perryrob/urban_micro/README.md

# urban_micro
Use OopenSCAD and modules to contruct a home in 3-D to achieve accurate part counts

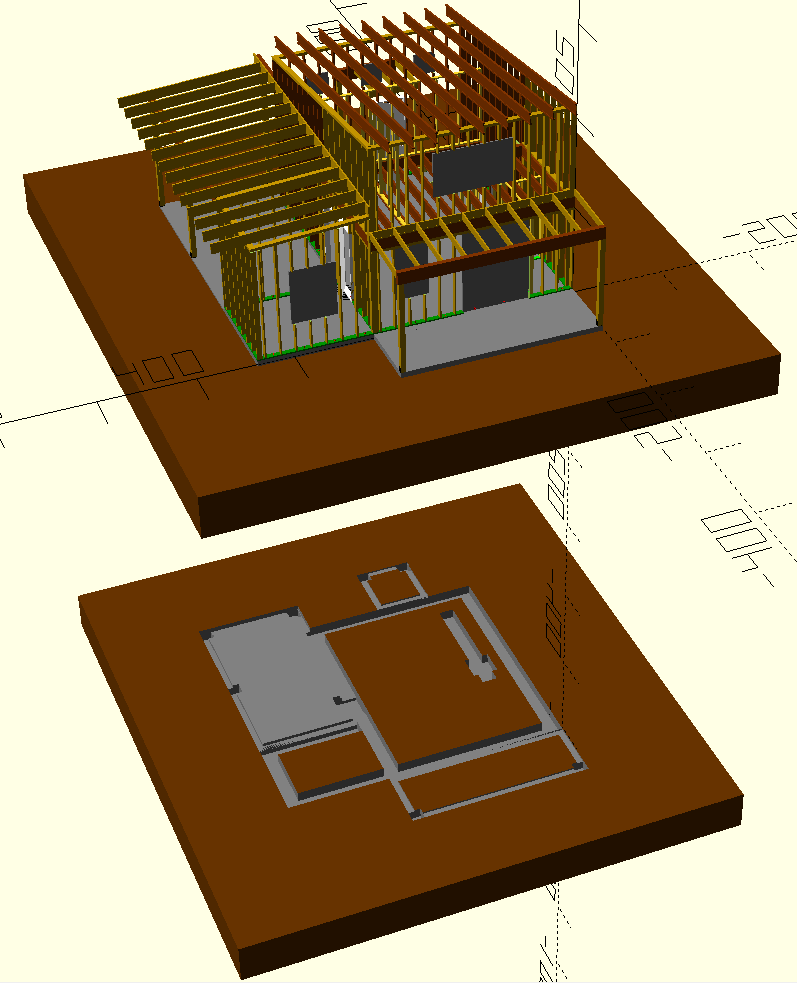
[picture p1: images/ortho.png]


clone and load "micro.scad"

# Requirements
* OpenSCAD installed
