perryrob/urban_micro/Urban_Micro_BOM.ods

Sheet: Sheet1
Category
Foundation
Brackets
 | Part | Qty | DWG Location | Est Price | Act Price | Total Est | Total Act | Notes
 | LSTHD8 | 10 | 3-A4 | $18.00 |  | $180.00
 | OCB46 | 3 | 3-A4 | $20.00 |  | $60.00
 | APB66 | 8 | 3-A4 | $50.00 |  | $400.00
 | ½ J bolts | 50 | 3-A4 | $1.70 |  | $85.00
 | SSTB 5/8 J Bolts | 12 | 1-A2 | $9.31 |  | $111.72
Slab | Part | Qty | DWG Location | Est Price | Act Price | Total Est | Total Act | Notes
 | #4 Rebarx20’ | 12 | 3-A4 | $12.00 |  | $144.00
 | Concrete | 20 | 3-A4 | $170.00 |  | $3,400.00
 | AB Gravel | 8 | 3-A4 | $60.00 |  | $480.00
 | Earth Work | 1 |  | $3,600.00 |  | $3,600.00 |  | labor
 | Trenching | 1 |  | $800.00 |  | $800.00 |  | labor
 | Plumbing | 1 |  | $4,500.00 |  | $4,500.00 |  | labor
 | Form | 1 |  | $2,000.00 |  | $2,000.00 |  | labor
Plumbing | Part | Qty | DWG Location | Est Price | Act Price | Total Est | Total Act | Notes
 | 3 inch Waste 10’ | 12 |  | $60.00 |  | $720.00
 | Waste Fittings | 6 |  | $10.00 |  | $60.00
 |  |  |  |  |  | $0.00
 |  |  |  |  |  | $0.00
 |  |  |  |  |  | $0.00
Windows | Part | Qty | DWG Location | Est Price | Act Price | Total Est | Total Act | Notes
 | 24”x24” Fixed | 3 |  | $450.36 |  | $1,351.08 |  | U-FACTOR OF 0.40 OR BETTER AND SOLAR HEAT GAIN COEFFICIENT OF 0.25 OR BETTER
 | 7'-0" x 4'-6" DBL. CASE | 1 |  | $3,449.70 |  | $3,449.70 |  | U-FACTOR OF 0.40 OR BETTER AND SOLAR HEAT GAIN COEFFICIENT OF 0.25 OR BETTER
 | 3'-0" x 4'-6" S.H | 1 |  | $1,156.00 |  | $1,156.00 |  | U-FACTOR OF 0.40 OR BETTER AND SOLAR HEAT GAIN COEFFICIENT OF 0.25 OR BETTER
 | 6'-0" x 8'-0" GLASS SLIDER | 1 |  | $5,602.71 |  | $5,602.71 |  | U-FACTOR OF 0.40 OR BETTER AND SOLAR HEAT GAIN COEFFICIENT OF 0.25 OR BETTER
 | 3'-0" x 5'-0" S.H. | 1 |  | $1,231.39 |  | $1,231.39 |  | U-FACTOR OF 0.40 OR BETTER AND SOLAR HEAT GAIN COEFFICIENT OF 0.25 OR BETTER
 | 4'-0" x 5'-0" S.H | 1 |  | $1,373.89 |  | $1,373.89 |  | U-FACTOR OF 0.40 OR BETTER AND SOLAR HEAT GAIN COEFFICIENT OF 0.25 OR BETTER
Doors | Part | Qty | DWG Location | Est Price | Act Price | Total Est | Total Act | Notes
 | Exterior 36”x96” | 1 |  | $1,828.29 |  | $1,828 |  | Right Hinged tempered partial glass
 | Interior 32”x80” | 2 |  | $215.00 |  | $430 |  | Right Handed hollow core
 | Exterior 32”x80” | 1 |  | $1,308.46 |  | $1,828 |  | Right Hinged tempered partial glass
 | Interior 32”x80” | 1 |  | $122.82 |  | $123 |  | Left Handed Opening
Toilets |  | Qty | DWG Location | Est Price | Act Price | Total Est | Total Act | Notes
 | Geberit 111.798.00.1 | 2 |  | $456.00 |  | $912 |  | https://www.amazon.com/Geberit-111-798-00-1-Concealed-Carrier-Dual-Flush/dp/B01C7FL4PK
 | Duravit 2226090092 Toilet Bowl | 2 |  | $340.00 |  | $680 |  | https://www.amazon.com/Duravit-2226090092-Toilet-Mounted-Starck/dp/B00F0IZMJ6
 |  |  |  |  |  | $0
 |  |  |  |  |  | $0
Main Floor Walls |  | Qty | DWG Location | Est Price | Act Price | Total Est | Total Act | Notes
 | Versalam 1 ½ x 5 ½ 16 ft EWN wall | 36 |  | $72.00 |  | $2,592
 | 2x6x12 Bottom Plate Treated | 10 |  | $10.00 |  | $100
 | 2x6x12 Top Plates | 20 |  | $20.00 |  | $400
 | CDX Sheathing | 24 |  | $31.00 |  | $744
 | Interior Walls | 0 |  |  |  |  |  | Guest Room
 | 2x6 12 foot | 30 |  | $12.00 |  | $360 |  | includes fire blocking
 | 2x4 8 foot | 23 |  | $7.12 |  | $164
 | 2x6 x 8 ft | 30 |  | $8.22 |  | $247
Upper Floor Walls |  | Qty | DWG Location | Est Price | Act Price | Total Est | Total Act | Notes
 | 2x4 10 foot | 10 |  | $7.12 |  | $71
 | 2x4x12 foot | 8 |  | $10.00 |  | $80
 |  | 4 |  | $20.00 |  | $80
 | CDX Sheathing | 0 |  | $47.00 |  | $0
 | 5 1/8" x 12" GLULAM 16 ft | 0 |  | $673.00 |  | $0
Upper Floor Framing |  | Qty | DWG Location | Est Price | Act Price | Total Est | Total Act | Notes
 | 11 7/8" FLOOR TJI's (230 SERIES) 12 footers | 15 |  | $168.00 |  | $2,520
 | Subfloor ¾ | 9 |  | $47.00 |  | $423
 | ITS Galvanized Top-Flange Joist Hanger for 2-5/16 in. x 11-7/8 in | 30 |  | $6.56 |  | $197
 | South Rim Joist
 | EW Rim Joist
Main Roof
 | 11 7/8" ROOF TJI's (560 SERIES) 24 footers | 12 |  | $335.76 |  | $4,029
 | CDX Sheeting | 21 |  | $31.00 |  | $651
 | Simpson H3 | 16 |  | $1.12 |  | $18
Carport and Guest Roof |  | Qty | DWG Location | Est Price | Act Price | Total Est | Total Act | Notes
 | Rafter Joists 2x12 12 ft | 12 |  | $12.00 |  | $144
 | 1x6 8 foot tongue and groove | 104 |  | $18.00 |  | $1,872
 | CDX Sheeting | 12 |  | $31.00 |  | $372
 | Sheeting | 8 |  | $46.55 |  | $372
 | Main Roof Fascia | 12 |  | $10.00 |  | $120
 | Simpson H3 | 30 |  | $1.12 |  | $34
 | Simpson LU36 | 12 |  | $2.68
 | 2x12 12 ft | 8 |  | $24.54 |  | $196
 | 5 1/2" x 9 3/4" GLULAM 20 foot | 1 |  | $500.00 |  | $500
Porches |  | Qty | DWG Location | Est Price | Act Price | Total Est | Total Act | Notes
 | 5 1/2" x 9 3/4" GLULAM 30 foot | 1 |  | $673.00 |  | $673
 | 6x6 Post 10 foot | 6 |  | $56.00 |  | $336
 | 6x6 Post 12foot | 2 |  | $67.00 |  | $134
 | Simpson O(E)CC 66 | 7 |  | $81.16 |  | $568
 | 5/8 in. x 8 in. Hot-Dip Galvanized Retrofit Bolt (2-Pack) | 21 |  | $19.00 |  | $399
 | Rafter Joists 2x8 8 ft | 10 |  | $10.12 |  | $101
 | 1x6 8 foot tongue and groove | 31 |  | $18.00 |  | $558
Electrical |  | Qty | DWG Location | Est Price | Act Price | Total Est | Total Act | Notes
 | 150 Amp 30-Space Outdoor Load Center Meter Main Combo with Main Breaker | 1 |  | $400.00 |  | $400
 | Misc mast rigging | 1 |  | $400.00 |  | $400
Bathroom |  | Qty | DWG Location | Est Price | Act Price | Total Est | Total Act | Notes
 | Sink KOHLER Cimarron 8 in. Widespread Vitreous China Pedestal Combo Bathroom | 2 |  | $312.00 |  | $624
 | Faucet MOEN Adler 4 in. Centerset 2-Handle | 2 |  | $60.00 |  | $120
 | Mirror JENSEN Horizon 16 in. W x 26 in. H x 4-3/4 in. D Frameless Recessed | 2 |  | $103.00 |  | $206
 | Shower | 2 |  | $2,000.00 |  | $4,000
Roof |  | Qty | DWG Location | Est Price | Act Price | Total Est | Total Act | Notes
 | Metal roof | 1 |  | $8,000.00 |  | $8,000
Stucco |  | Qty | DWG Location | Est Price | Act Price | Total Est | Total Act | Notes
 | Stucco | 1 |  | $8,000.00 |  | $8,000
Appliances |  | Qty | DWG Location | Est Price | Act Price | Total Est | Total Act | Notes
 | Refrigerator | 1 |  | $1,500.00 |  | $1,500
 | Dishwasher | 1 |  | $800.00 |  | $800
 | Sink | 1 |  | $400.00 |  | $400
 | Stove | 1 |  | $1,100.00 |  | $1,100
 | Counter | 1 |  | $1,000.00 |  | $1,000
 | Cabinets | 1 |  | $4,000.00 |  | $4,000
Flooring |  | Qty | DWG Location | Est Price | Act Price | Total Est | Total Act | Notes
 | Bamboo Flooring Eco Forest Premium Carbonized | 700 |  | $3.00 |  | $2,100
MISC |  | Qty | DWG Location | Est Price | Act Price | Total Est | Total Act | Notes
 | Tyvek $224 / 1350 2100 AREA | 2 |  | $224.00 |  | $448
 | Drywall ½ inch Ultralight | 105 |  | $16.58 |  | $1,741
 | Drywall ½ inch Ultralight Green | 20 |  | $23.93 |  | $479
 | Spray Foam | 1 |  | $1,800.00 |  | $1,800
 | Permitting | 1 |  | $8,000.00 | 4902.64 | $8,000

Sheet: Sheet2
Main Interior
 | East Wall | 24
 | North Wall | 18
 | West Wall | 24
 | South Wall | 18
Guest | North Wall | 10.5
 | West Wall | 9
 | South Wall | 10.5
Enclosed Perimeter |  | 114
Main Surface Area
 | East Wall
 |  | H1
 |  |  | 14.1666666666667
 |  | H2
 |  |  | 18
 | Area | 386
 | West Wall | 278
Guest | West Wall | 90
 | North Wall | 120
 | South Wall | 120
Main Roof
South | 20
West | 28
 | Area | 560
Carport+Guest | 30
 | 12
 | Area | 360
Porch
 | 18
 | 6
 | Area | 108
 | 6
 | 4
 |  | 24
