perryrob/urban_micro/foundation.scad

function ft(d) = 12.0*d ;

// Southeast is 0,0,0
slab_north = ft(23)+9+0.25;
slab_west = ft(18)+0.25;
slab_thk = 4;

g_slab_north = ft(8)+9+0.25;
g_slab_west = ft(10)+1+.75;

d_slab_north = ft(18)+10+.5;
d_slab_west = ft(10)+7+0.75;

p_slab_north = ft(6)+1+0.5;
p_slab_west = ft(18)+0.25;

dr_slab_north = ft(6)+1+0.5;
dr_slab_west = ft(5)+7+0.5;

ex_footer_width=ft(1);

toe_down_width=8;

MAIN_SLAB=[slab_north,slab_west,slab_thk];

module concrete(){
  color([0.5,0.5,0.5]) children();
}
module black_steel(){
   color([0,0,0]) children();
}

module APVB66() {
  echo("{name='Simpson 4x4 APVB66', type='bracket', qty=1}");
  echo("{name='5/8 J-Bolt', type='jbolt', length=8, qty=1}");
  black_steel()
    union(){
    cube([5,5.5,0.75]);
    difference(){
      union() {
        cube([5,0.125,6]);
        translate([0,5.5,0])
          cube([5,0.125,6]);
      }
      union(){
        translate([1.0,-3,4.5])
          rotate([-90,0,0])
          cylinder(d=0.75,h=10);
        translate([4,-3,4.5])
          rotate([-90,0,0])
          cylinder(d=0.75,h=10);
      }
    }
  }
}
module CB46(){
  echo("{name='Simpson 4x4 CB46', type='bracket', qty=1}");
  black_steel()
    difference(){
    union(){
      translate([0,(3+9/16)/2,0])
        cube([3,0.125,10],center=true);
      translate([0,-(3+9/16)/2,0])
        cube([3,0.125,10],center=true);
      cube([5.5,3+9/16,0.125],center=true);
    }
    union(){
      translate([0,-4,4.325])
        rotate([-90,0,0])
        cylinder(d=0.75,h=10);
      translate([0,-4,2])
        rotate([-90,0,0])
      cylinder(d=0.75,h=10);
    }
  }
}

module j_bolt(){
  echo("{name='1/2 J-Bolt', type='jbolt', length=12, qty=1}");
  dia=1/2;
  SE()
    translate([0,0,slab_thk-12+3])
    color([1,0,0])
    cylinder(d=dia, h=12);
  translate([0,0,5.5])
    color([1,0,0])
    cylinder(d=2, h=0.125);
  translate([0,0,5.75])
    color([1,0,0])
    cube([1,1,0.5],center=true);

}

module wood_column_footing(position){
  depth=18;
  dim=ft(2)+6;
  if(position == 0){
    APVB66();
    concrete()
      translate([-dim/2+5/2,-dim/2+5.5/2,-depth])
      cube([dim,dim,depth]);
  }
  if(position == 1200){
    APVB66();
    concrete()
      translate([-dim/2+5,-dim/4+5.5/2,-depth])
      cube([dim/2,dim/2,depth]);
  }
  if(position == 130){
    APVB66();
    concrete()
      translate([-dim/2+5,0,-depth])
      cube([dim/2,dim/2,depth]);
  }
  if(position == 300){
    APVB66();
    concrete()
      translate([-dim/4+5/2,0,-depth])
      cube([dim/2,dim/2,depth]);
  }
  if(position == 430){
    APVB66();
    concrete()
      translate([0,0,-depth])
      cube([dim/2,dim/2,depth]);
  }
  if(position == 600){
    APVB66();
    concrete()
      translate([0,-dim/4+5.5/2,-depth])
      cube([dim/2,dim/2,depth]);
  }
  if(position == 730){
    APVB66();
    concrete()
      translate([0,-dim/2+5.5,-depth])
      cube([dim/2,dim/2,depth]);
  }
  if(position == 900){
    APVB66();
    concrete()
      translate([-dim/4+5/2,-dim/2+5.5,-depth])
      cube([dim/2,dim/2,depth]);
  }
  if(position == 1030){
    APVB66();
    concrete()
      translate([-dim/4-5/2,-dim/2+5.5,-depth])
      cube([dim/2,dim/2,depth]);
  }
}

module interior_wood_post_footing(){
  translate([0,0,-9])
    concrete()
    cube([ft(2)+6,ft(2)+6,18],center=true);
  translate([0,-1,0])
    CB46();
}

module interior_wall_footing(length,rotation){
  depth=18;
  if(rotation==0) {
    concrete()
      translate([0,0,-depth+slab_thk])
      cube([length,ft(1)+6,depth]);
  } else {
    concrete()
      translate([ft(1)+6,0,-depth+slab_thk])
      rotate([0,0,90])
      cube([length,ft(2)+6,depth]);
  }
}
module exterior_footing(length,rotation){
  depth=18;
  if(rotation==0) {
    concrete()
    translate([0,0,-depth+slab_thk])
      cube([length,ex_footer_width,depth]);
  } else {
    concrete()
    translate([ex_footer_width,0,-depth+slab_thk])
      rotate([0,0,90])
      cube([length,ex_footer_width,depth]);    
  }
}

module toedown_footing(length,rotation){
  depth=toe_down_width;
  if(rotation==0) {
    concrete()
    translate([0,0,-depth+slab_thk])
      cube([length,depth,depth]);
  } else {
    concrete()
      translate([depth,0,-depth+slab_thk])
      rotate([0,0,90])
      cube([length,depth,depth]);    
  }
}

module X(){
  translate([0,0,0]) children();
}
module NW(){
  X()
    translate([slab_north,slab_west,0]) children();
}
module SW(){
  X()
    translate([0,slab_west,0]) children();
}
module SE(){
  X()
    translate([0,0,0]) children();
}
module NE(){
  X()
    translate([slab_north,0,0]) children();
}
module EXTRA(){
  X()
    translate([0,-ft(10),0]) children();
}
// =====================================================
module main_slab() {

  step=4;
  
  X()
    concrete()
    cube( MAIN_SLAB );

  exterior_footing(slab_north,0);
  exterior_footing(slab_west,1);
  
  SW()
    translate([0,-ex_footer_width,0])
    exterior_footing(slab_north,0);
  
  NE()
    translate([-ex_footer_width,0,0])
    exterior_footing(slab_west,1);
  
  translate([ft(9)+3,ft(3),0])
    interior_wall_footing(ft(11)+7, 0);
  /* ERROR this translation is off */
    translate([ft(11)+8+0.5, ft(3)+8.25,slab_thk])
      interior_wood_post_footing();
  SW()    
    translate([ft(11)+12+0.5,-5.5,slab_thk-step])
    rotate([0,0,90])
    wood_column_footing(0);

}
/* main floor wall test to mid wall*/
/*
color([0,01])
translate([ft(11)+8.5,0,0])
cube([10,ft(3)+6.5+3.5/2,10]);
*/
module guest_slab() {
  SW()
    concrete()
    cube( [g_slab_north, g_slab_west,slab_thk]);

   SW()
    translate([0,g_slab_west-ex_footer_width,0])
    exterior_footing(g_slab_north,0);

  SW()
    exterior_footing(g_slab_north+12,1);

  SW()
    translate([g_slab_north-ex_footer_width,0,0])
    exterior_footing(g_slab_north+12,1);

}
module drive_slab() {
  SW()
    concrete()
    translate([g_slab_north,g_slab_west-d_slab_west,0])
  cube( [ d_slab_north,d_slab_west,slab_thk ] );

  SW()
    translate([g_slab_north,g_slab_west-d_slab_west,0])
    toedown_footing(d_slab_north,0);
   SW()
     translate([g_slab_north,
                g_slab_west-d_slab_west+d_slab_west-toe_down_width,0])
     toedown_footing(d_slab_north,0);
  SW()
    translate([g_slab_north,g_slab_west-d_slab_west,0])
    toedown_footing(d_slab_west,1);
  SW()
    translate([g_slab_north+d_slab_north-toe_down_width,
               g_slab_west-d_slab_west,0])
    toedown_footing(d_slab_west,1);

  SW()
    translate([g_slab_north+d_slab_north-5,
               g_slab_west-5.5,slab_thk])
    wood_column_footing(1030);

  SW()
    translate([g_slab_north+d_slab_north-5,
               -5.5,slab_thk])
    wood_column_footing(130);

  SW()
    translate([g_slab_north+d_slab_north/2-5,
               g_slab_west-5.5,slab_thk])
    wood_column_footing(900);

}
module porch_slab(){
  SE()
    concrete()
    translate([-p_slab_north,0,0])
  cube([p_slab_north,p_slab_west,slab_thk]);

  translate([-p_slab_north,0,0])
    toedown_footing(p_slab_north,0);
  translate([-p_slab_north,p_slab_west-toe_down_width])
    toedown_footing(p_slab_north,0);

  translate([-toe_down_width,0,0])
    toedown_footing(p_slab_west,1);

  translate([-p_slab_north,0,0])
    toedown_footing(p_slab_west,1);

  SE()
    translate([-p_slab_north,0,slab_thk])
    wood_column_footing(430);  
  SE()
    translate([-p_slab_north,p_slab_west-5.5,slab_thk])
    wood_column_footing(730);  
  
}

module door_slab(){
  NE()
    concrete()
    translate([0,ft(4)+6+0.5,0])
    cube([dr_slab_north,dr_slab_west,slab_thk]);
  NE()
    translate([0,ft(4)+6+0.5,0])
    toedown_footing(dr_slab_north,0);
  NE()
    translate([0,ft(4)+6+0.5+dr_slab_west-toe_down_width,0])
    toedown_footing(dr_slab_north,0);

  NE()
    translate([0,ft(4)+6+0.0,0])
    toedown_footing(dr_slab_west,1);

  NE()
    translate([dr_slab_north-toe_down_width,ft(4)+6+0.0,0])
    toedown_footing(dr_slab_west,1);

  NE()
    translate([dr_slab_north-5,ft(4)+6+0.5,slab_thk])
    wood_column_footing(130);
  NE()
    translate([dr_slab_north-5,ft(4)+6+0.5+dr_slab_west-5,slab_thk])
    wood_column_footing(1030);  
}

module exterior_jbolts(){

  min_spacing = 32;

  /* East Wall */
  
  SE()
    for(i = [0:min_spacing:min_spacing*8]) {
      translate([9.5+i, 5.5/2 ,0])
        j_bolt();
    }
  /* North Wall */
  NE()
    for(i = [0:min_spacing:min_spacing*6]) {
      translate([-5.5/2,9+i, ,0])
        j_bolt();
    }
  /* South Wall */
  SE()
    for(i = [0:min_spacing:min_spacing*6]) {
      translate([5.5/2,11+i, ,0])
        j_bolt();
    }
  SW()
    for(i = [0:min_spacing:min_spacing*3]) {
      translate([5.5/2,8+i, ,0])
        j_bolt();
    }
  /* Guest Walls */
  SW()
    for(i = [0:min_spacing:min_spacing*2]) {
      translate([8+i,ft(10)-1, ,0])
        j_bolt();
    }
  SW(){
    for(i = [0:min_spacing:min_spacing*3]) {
      translate([ft(9)-5.25,i+6,0])
        j_bolt();
    }
  }
  /* West Wall */
  SW(){
    for(i = [0:min_spacing:min_spacing*8]) {
      translate([i+8,-5.5/2,0])
        j_bolt();
    }
  }
}

module interior_slab() {
  main_slab();
  guest_slab();
}

module slab(){
  echo("{name='Simpson LSTHD8', type='strap', length=8, qty=10}");
  union() {
    interior_slab();
    translate([0,0,-4])
      drive_slab();
    porch_slab();
    door_slab();
  }
  exterior_jbolts();
}


module lot(){
  
  color([.4,.2,0])
    translate([-ft(15),-ft(12),-ft(4)+4-6])
    cube([ft(53),ft(50),ft(4)]);
  
}
