perryrob/urban_micro/(commit log)

2024-06-03 initial github commit.
    [TJI.scad, Urban_Micro_BOM.ods, foundation.scad, framing.scad, micro.scad, windows_doors.scad]
2024-06-05 added doors
    [framing.scad, micro.scad, windows_doors.scad]
2024-06-07 cleanup and guest error
    [foundation.scad, framing.scad, micro.scad, windows_doors.scad]
2024-06-10 moved back botttom plates in guest room
    [foundation.scad, framing.scad]
2024-06-11 added j bolts and interior framing stuff.
    [foundation.scad, framing.scad, interior_framing.scad, micro.scad]
2024-06-24 Added stair treads
    [foundation.scad, framing.scad, stair.scad]
2024-06-25 minor tweaks and stairs.
    [foundation.scad, framing.scad, micro.scad, stair.scad]
2024-06-26 added j bolts
    [framing.scad, interior_framing.scad, j_bolt_holder.scad, micro.scad]
2024-06-27 The only parts left are upstairs closet, upstairs pocket door and some rough plumbing.
    [Urban_Micro_BOM.ods, foundation.scad, framing.scad, interior_framing.scad, j_bolt_holder.scad, micro.scad, stair.scad, windows_doors.scad]
2024-06-27 Fixed the placement of the main floor interior wall.
    [foundation.scad, framing.scad, interior_framing.scad, micro.scad, stair.scad, windows_doors.scad]
2024-07-23 Added BOM code to scad files and added bom.py for parsing.
    [TJI.scad, Urban_Micro_BOM.ods, foundation.scad, framing.scad, interior_framing.scad, j_bolt_holder.scad, micro.scad, plumbing.scad]
2024-07-23 Updated part callouts
    [TJI.scad, framing.scad, micro.scad, stair.scad]
2024-07-23 removed the 5 1/8 glue lams and replaced them with 5 1/2
    [framing.scad]
2024-07-26 Optimized the J-bolt holder
    [j_bolt_holder.scad]
2024-08-01 Updated framing to properly place the TJIs on the 2nd follr
    [framing.scad, micro.scad]
